kikangman/Surfshot/hardware/kicad-integrated/BOM.csv

Ref | Value | Footprint | DNP | Sheet
J1 | PROTECTED_CELL |  | False | /b182998e-1854-4d79-868d-e37b2476ee9a
F1 | 6.3A provisional |  | False | /b182998e-1854-4d79-868d-e37b2476ee9a
U2 | TPS62162DSG | Package_SON:Texas_DSG0008A_WSON-8-1EP_2x2mm_P0.5mm_EP0.9x1.6mm_ThermalVias | False | /b182998e-1854-4d79-868d-e37b2476ee9a
C1 | 10u / 10V | Capacitor_SMD:C_0805_2012Metric | False | /b182998e-1854-4d79-868d-e37b2476ee9a
L1 | 2.2uH / Isat>=2A |  | False | /b182998e-1854-4d79-868d-e37b2476ee9a
C2 | 22u / 10V | Capacitor_SMD:C_0805_2012Metric | False | /b182998e-1854-4d79-868d-e37b2476ee9a
U1 | ESP32-WROOM-32E-N4 | RF_Module:ESP32-WROOM-32E | False | /b182998e-1854-4d79-868d-e37b2476ee9a
C3 | 10u / 10V | Capacitor_SMD:C_0805_2012Metric | False | /b182998e-1854-4d79-868d-e37b2476ee9a
C4 | 100n | Capacitor_SMD:C_0603_1608Metric | False | /b182998e-1854-4d79-868d-e37b2476ee9a
U3 | ULN2003A | Package_SO:SOIC-16_3.9x9.9mm_P1.27mm | False | /b182998e-1854-4d79-868d-e37b2476ee9a
J4 | MOTOR_A |  | False | /b182998e-1854-4d79-868d-e37b2476ee9a
C5 | 100n / 25V | Capacitor_SMD:C_0603_1608Metric | False | /b182998e-1854-4d79-868d-e37b2476ee9a
R1 | 47k | Resistor_SMD:R_0603_1608Metric | False | /b182998e-1854-4d79-868d-e37b2476ee9a
R2 | 47k | Resistor_SMD:R_0603_1608Metric | False | /b182998e-1854-4d79-868d-e37b2476ee9a
R3 | 47k | Resistor_SMD:R_0603_1608Metric | False | /b182998e-1854-4d79-868d-e37b2476ee9a
R4 | 47k | Resistor_SMD:R_0603_1608Metric | False | /b182998e-1854-4d79-868d-e37b2476ee9a
U4 | ULN2003A | Package_SO:SOIC-16_3.9x9.9mm_P1.27mm | False | /b182998e-1854-4d79-868d-e37b2476ee9a
J5 | MOTOR_B |  | False | /b182998e-1854-4d79-868d-e37b2476ee9a
C6 | 100n / 25V | Capacitor_SMD:C_0603_1608Metric | False | /b182998e-1854-4d79-868d-e37b2476ee9a
R5 | 47k | Resistor_SMD:R_0603_1608Metric | False | /b182998e-1854-4d79-868d-e37b2476ee9a
R6 | 47k | Resistor_SMD:R_0603_1608Metric | False | /b182998e-1854-4d79-868d-e37b2476ee9a
R7 | 47k | Resistor_SMD:R_0603_1608Metric | False | /b182998e-1854-4d79-868d-e37b2476ee9a
R8 | 47k | Resistor_SMD:R_0603_1608Metric | False | /b182998e-1854-4d79-868d-e37b2476ee9a
R9 | 10k | Resistor_SMD:R_0603_1608Metric | False | /b182998e-1854-4d79-868d-e37b2476ee9a
SW1 | RESET | Button_Switch_SMD:SW_SPST_TL3342 | False | /b182998e-1854-4d79-868d-e37b2476ee9a
R10 | 10k | Resistor_SMD:R_0603_1608Metric | False | /b182998e-1854-4d79-868d-e37b2476ee9a
SW2 | BOOT | Button_Switch_SMD:SW_SPST_TL3342 | False | /b182998e-1854-4d79-868d-e37b2476ee9a
C7 | 1u | Capacitor_SMD:C_0603_1608Metric | False | /b182998e-1854-4d79-868d-e37b2476ee9a
R11 | 10k | Resistor_SMD:R_0603_1608Metric | False | /b182998e-1854-4d79-868d-e37b2476ee9a
R12 | 10k | Resistor_SMD:R_0603_1608Metric | False | /b182998e-1854-4d79-868d-e37b2476ee9a
R13 | 100k 1% | Resistor_SMD:R_0603_1608Metric | False | /b182998e-1854-4d79-868d-e37b2476ee9a
R14 | 100k 1% | Resistor_SMD:R_0603_1608Metric | False | /b182998e-1854-4d79-868d-e37b2476ee9a
C8 | 100n | Capacitor_SMD:C_0603_1608Metric | False | /b182998e-1854-4d79-868d-e37b2476ee9a
J2 | UART_3V3_LEVEL |  | False | /b182998e-1854-4d79-868d-e37b2476ee9a
J3 | LORA_EXPANSION |  | False | /b182998e-1854-4d79-868d-e37b2476ee9a
U5 | TPS61089RNR | Package_DFN_QFN:Texas_VQFN-RNR0011A-11 | False | /b182998e-1854-4d79-868d-e37b2476ee9a/4dbb8aff-9271-4933-bceb-92a873d27105
L2 | 2.2uH / Isat>=8A |  | False | /b182998e-1854-4d79-868d-e37b2476ee9a/4dbb8aff-9271-4933-bceb-92a873d27105
C9 | 22u / 10V | Capacitor_SMD:C_1206_3216Metric | False | /b182998e-1854-4d79-868d-e37b2476ee9a/4dbb8aff-9271-4933-bceb-92a873d27105
C10 | 100n / 16V | Capacitor_SMD:C_0603_1608Metric | False | /b182998e-1854-4d79-868d-e37b2476ee9a/4dbb8aff-9271-4933-bceb-92a873d27105
C16 | 100n / 16V | Capacitor_SMD:C_0603_1608Metric | False | /b182998e-1854-4d79-868d-e37b2476ee9a/4dbb8aff-9271-4933-bceb-92a873d27105
R18 | 316k 1% | Resistor_SMD:R_0603_1608Metric | False | /b182998e-1854-4d79-868d-e37b2476ee9a/4dbb8aff-9271-4933-bceb-92a873d27105
R15 | 312k 0.1% | Resistor_SMD:R_0603_1608Metric | False | /b182998e-1854-4d79-868d-e37b2476ee9a/4dbb8aff-9271-4933-bceb-92a873d27105
R16 | 100k 0.1% | Resistor_SMD:R_0603_1608Metric | False | /b182998e-1854-4d79-868d-e37b2476ee9a/4dbb8aff-9271-4933-bceb-92a873d27105
C11 | 22u / 25V | Capacitor_SMD:C_1210_3225Metric | False | /b182998e-1854-4d79-868d-e37b2476ee9a/4dbb8aff-9271-4933-bceb-92a873d27105
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
C23 | 15n | Capacitor_SMD:C_0603_1608Metric | False | /b182998e-1854-4d79-868d-e37b2476ee9a/4dbb8aff-9271-4933-bceb-92a873d27105
C24 | 10p DNP | Capacitor_SMD:C_0603_1608Metric | True | /b182998e-1854-4d79-868d-e37b2476ee9a/4dbb8aff-9271-4933-bceb-92a873d27105
