kikangman/Surfshot/hardware/kicad-integrated/Power.kicad_sch

## KiCad design hardware/kicad-integrated/Power.kicad_sch (2026-10-28)

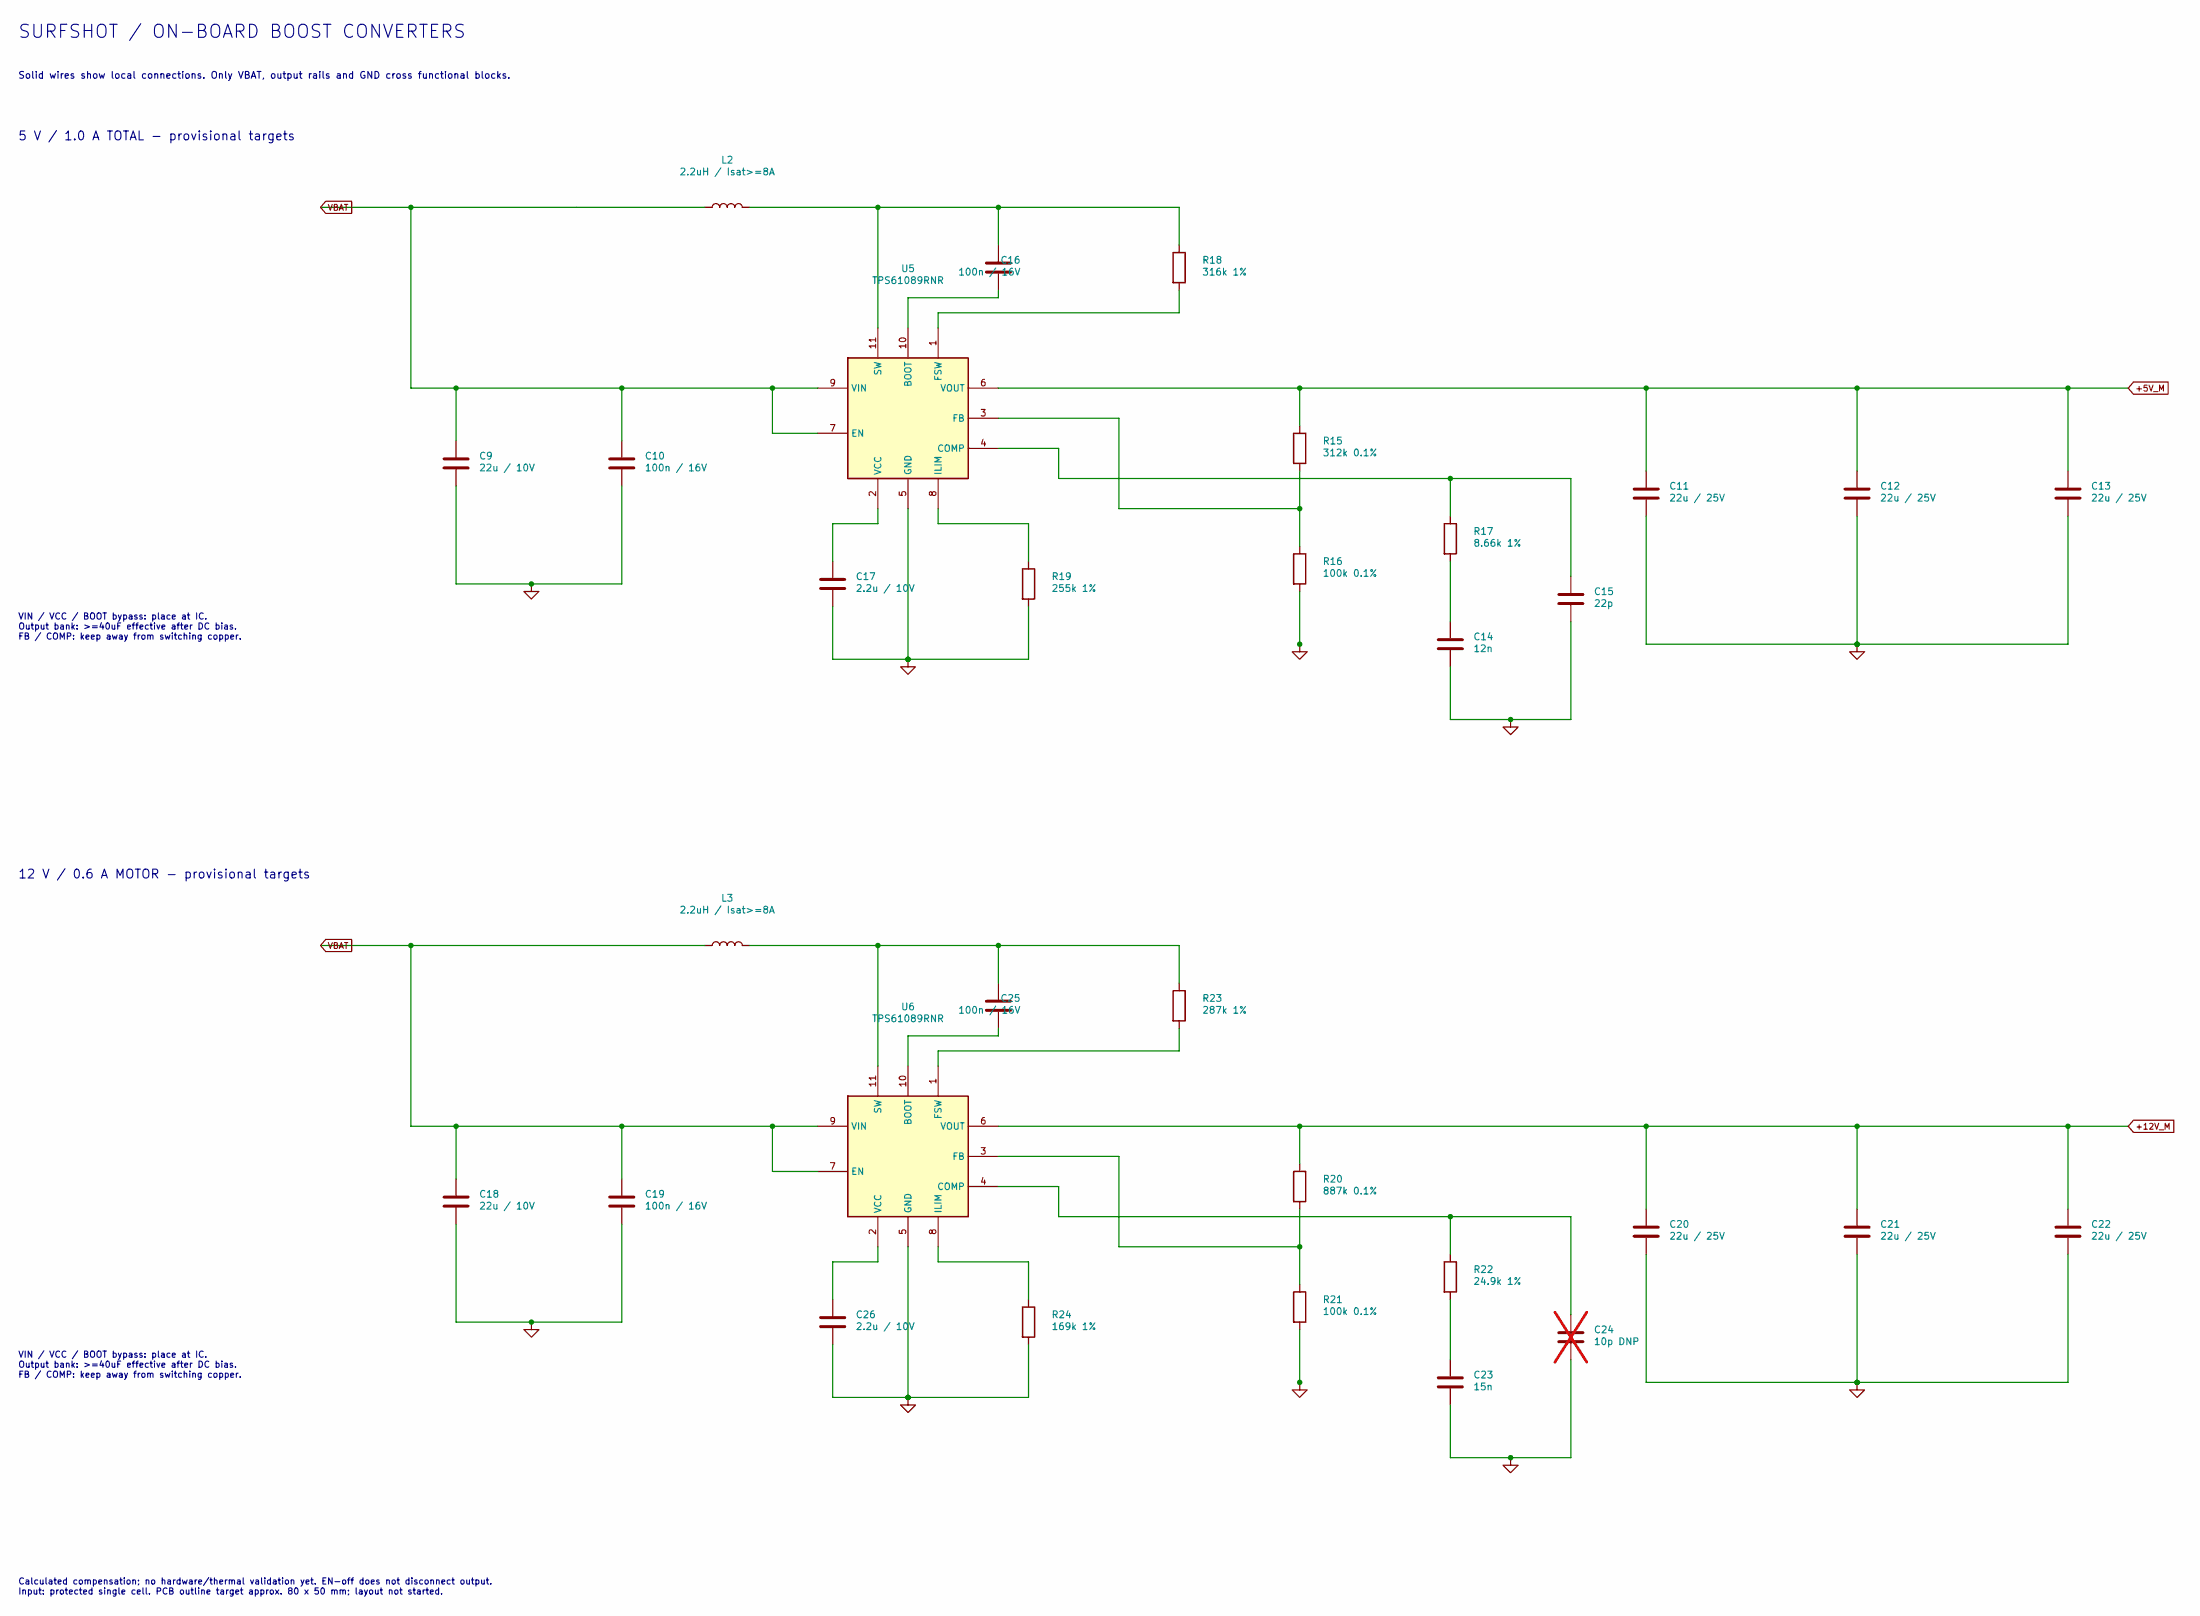
[picture p1: schematic Power.kicad_sch]

Parts:
C9, C18: 22u / 10V; C_1206_3216Metric
C10, C16, C19, C25: 100n / 16V; C_0603_1608Metric
C11, C12, C13, C20, C21, C22: 22u / 25V; C_1210_3225Metric
C14: 12n; C_0603_1608Metric
C15: 22p; C_0603_1608Metric
C17, C26: 2.2u / 10V; C_0603_1608Metric
C23: 15n; C_0603_1608Metric
C24: 10p DNP; C_0603_1608Metric; not fitted
L2, L3: 2.2uH / Isat>=8A
R15: 312k 0.1%; R_0603_1608Metric
R16, R21: 100k 0.1%; R_0603_1608Metric
R17: 8.66k 1%; R_0603_1608Metric
R18: 316k 1%; R_0603_1608Metric
R19: 255k 1%; R_0603_1608Metric
R20: 887k 0.1%; R_0603_1608Metric
R22: 24.9k 1%; R_0603_1608Metric
R23: 287k 1%; R_0603_1608Metric
R24: 169k 1%; R_0603_1608Metric
U5, U6: TPS61089RNR; Texas_VQFN-RNR0011A-11

Connections:
+5V_M: C11.1, C12.1, C13.1, R15.1, U5.6 (VOUT)
+12V_M: C20.1, C21.1, C22.1, R20.1, U6.6 (VOUT)
GND: C9.2, C10.2, C11.2, C12.2, C13.2, C14.2, C15.2, C17.2, C18.2, C19.2, C20.2, C21.2, C22.2, C23.2, C24.2, C26.2, R16.2, R19.2, R21.2, R24.2, U5.5 (GND), U6.5 (GND)
unnamed: C14.1, R17.2
unnamed: C15.1, R17.1, U5.4 (COMP)
unnamed: C16.1, U5.10 (BOOT)
unnamed: C16.2, L2.2, R18.1, U5.11 (SW)
unnamed: C17.1, U5.2 (VCC)
unnamed: C23.1, R22.2
unnamed: C24.1, R22.1, U6.4 (COMP)
unnamed: C25.1, U6.10 (BOOT)
unnamed: C25.2, L3.2, R23.1, U6.11 (SW)
unnamed: C26.1, U6.2 (VCC)
unnamed: R15.2, R16.1, U5.3 (FB)
unnamed: R18.2, U5.1 (FSW)
unnamed: R19.1, U5.8 (ILIM)
unnamed: R20.2, R21.1, U6.3 (FB)
unnamed: R23.2, U6.1 (FSW)
unnamed: R24.1, U6.8 (ILIM)
VBAT: C9.1, C10.1, C18.1, C19.1, L2.1, L3.1, U5.7 (EN), U5.9 (VIN), U6.7 (EN), U6.9 (VIN)

Notes on the sheet:
SURFSHOT / ON-BOARD BOOST CONVERTERS
Solid wires show local connections. Only VBAT, output rails and GND cross functional blocks.
5 V / 1.0 A TOTAL - provisional targets
VIN / VCC / BOOT bypass: place at IC. Output bank: >=40uF effective after DC bias. FB / COMP: keep away from switching copper.
12 V / 0.6 A MOTOR - provisional targets
Calculated compensation; no hardware/thermal validation yet. EN-off does not disconnect output. Input: protected single cell. PCB outline target approx. 80 x 50 mm; layout not started.
