kikangman/Surfshot/hardware/kicad-integrated/Surfshot_Integrated.kicad_sch

## KiCad design hardware/kicad-integrated/Surfshot_Integrated.kicad_sch (2026-10-28)

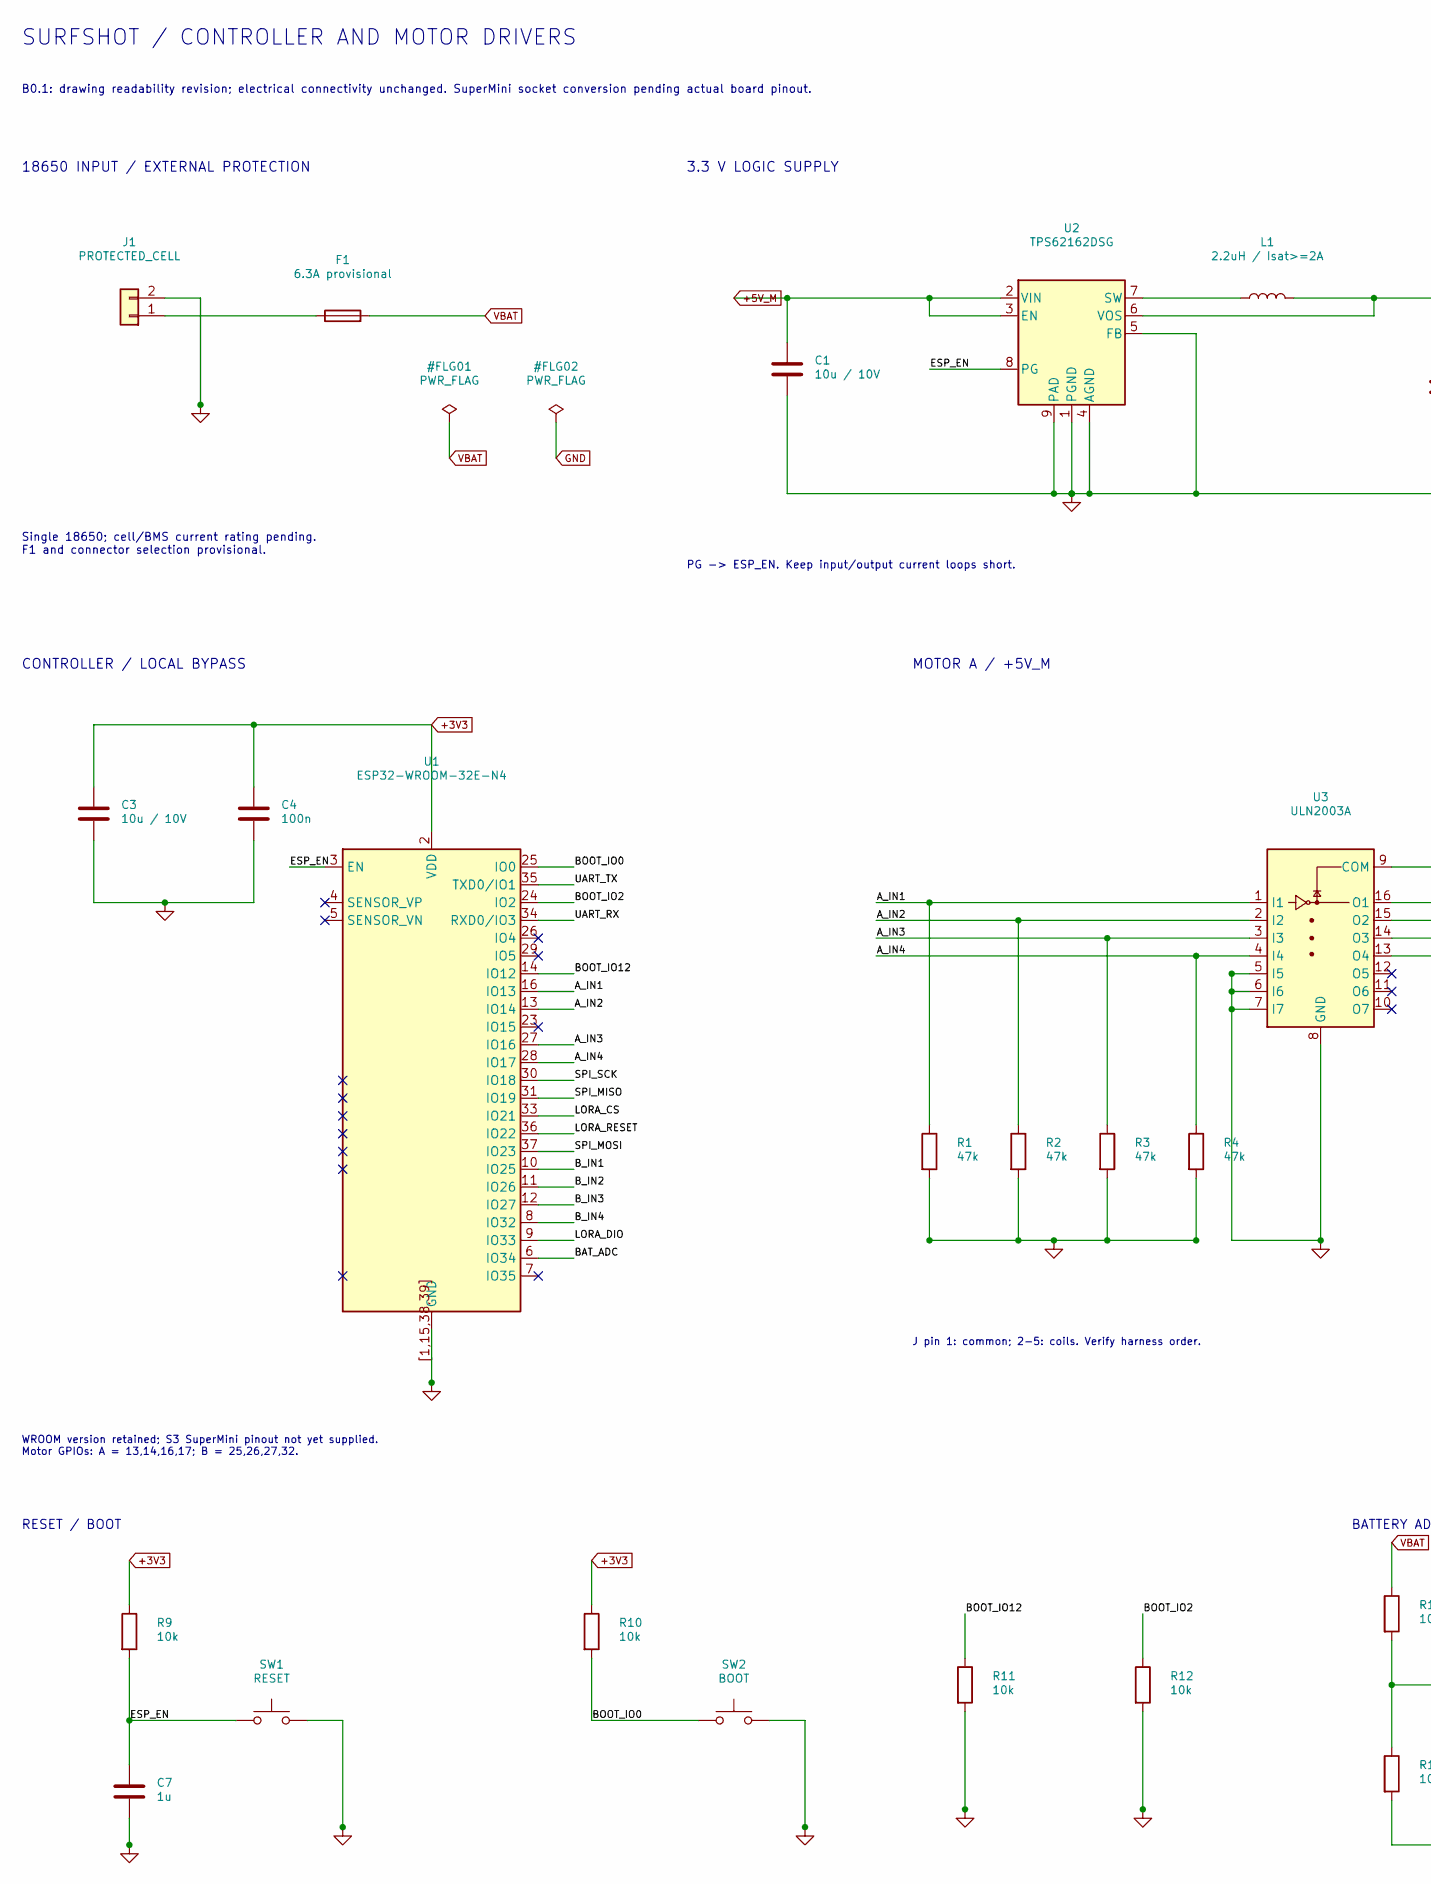
[picture p2: schematic Surfshot_Integrated.kicad_sch, part in row 1, column 1]

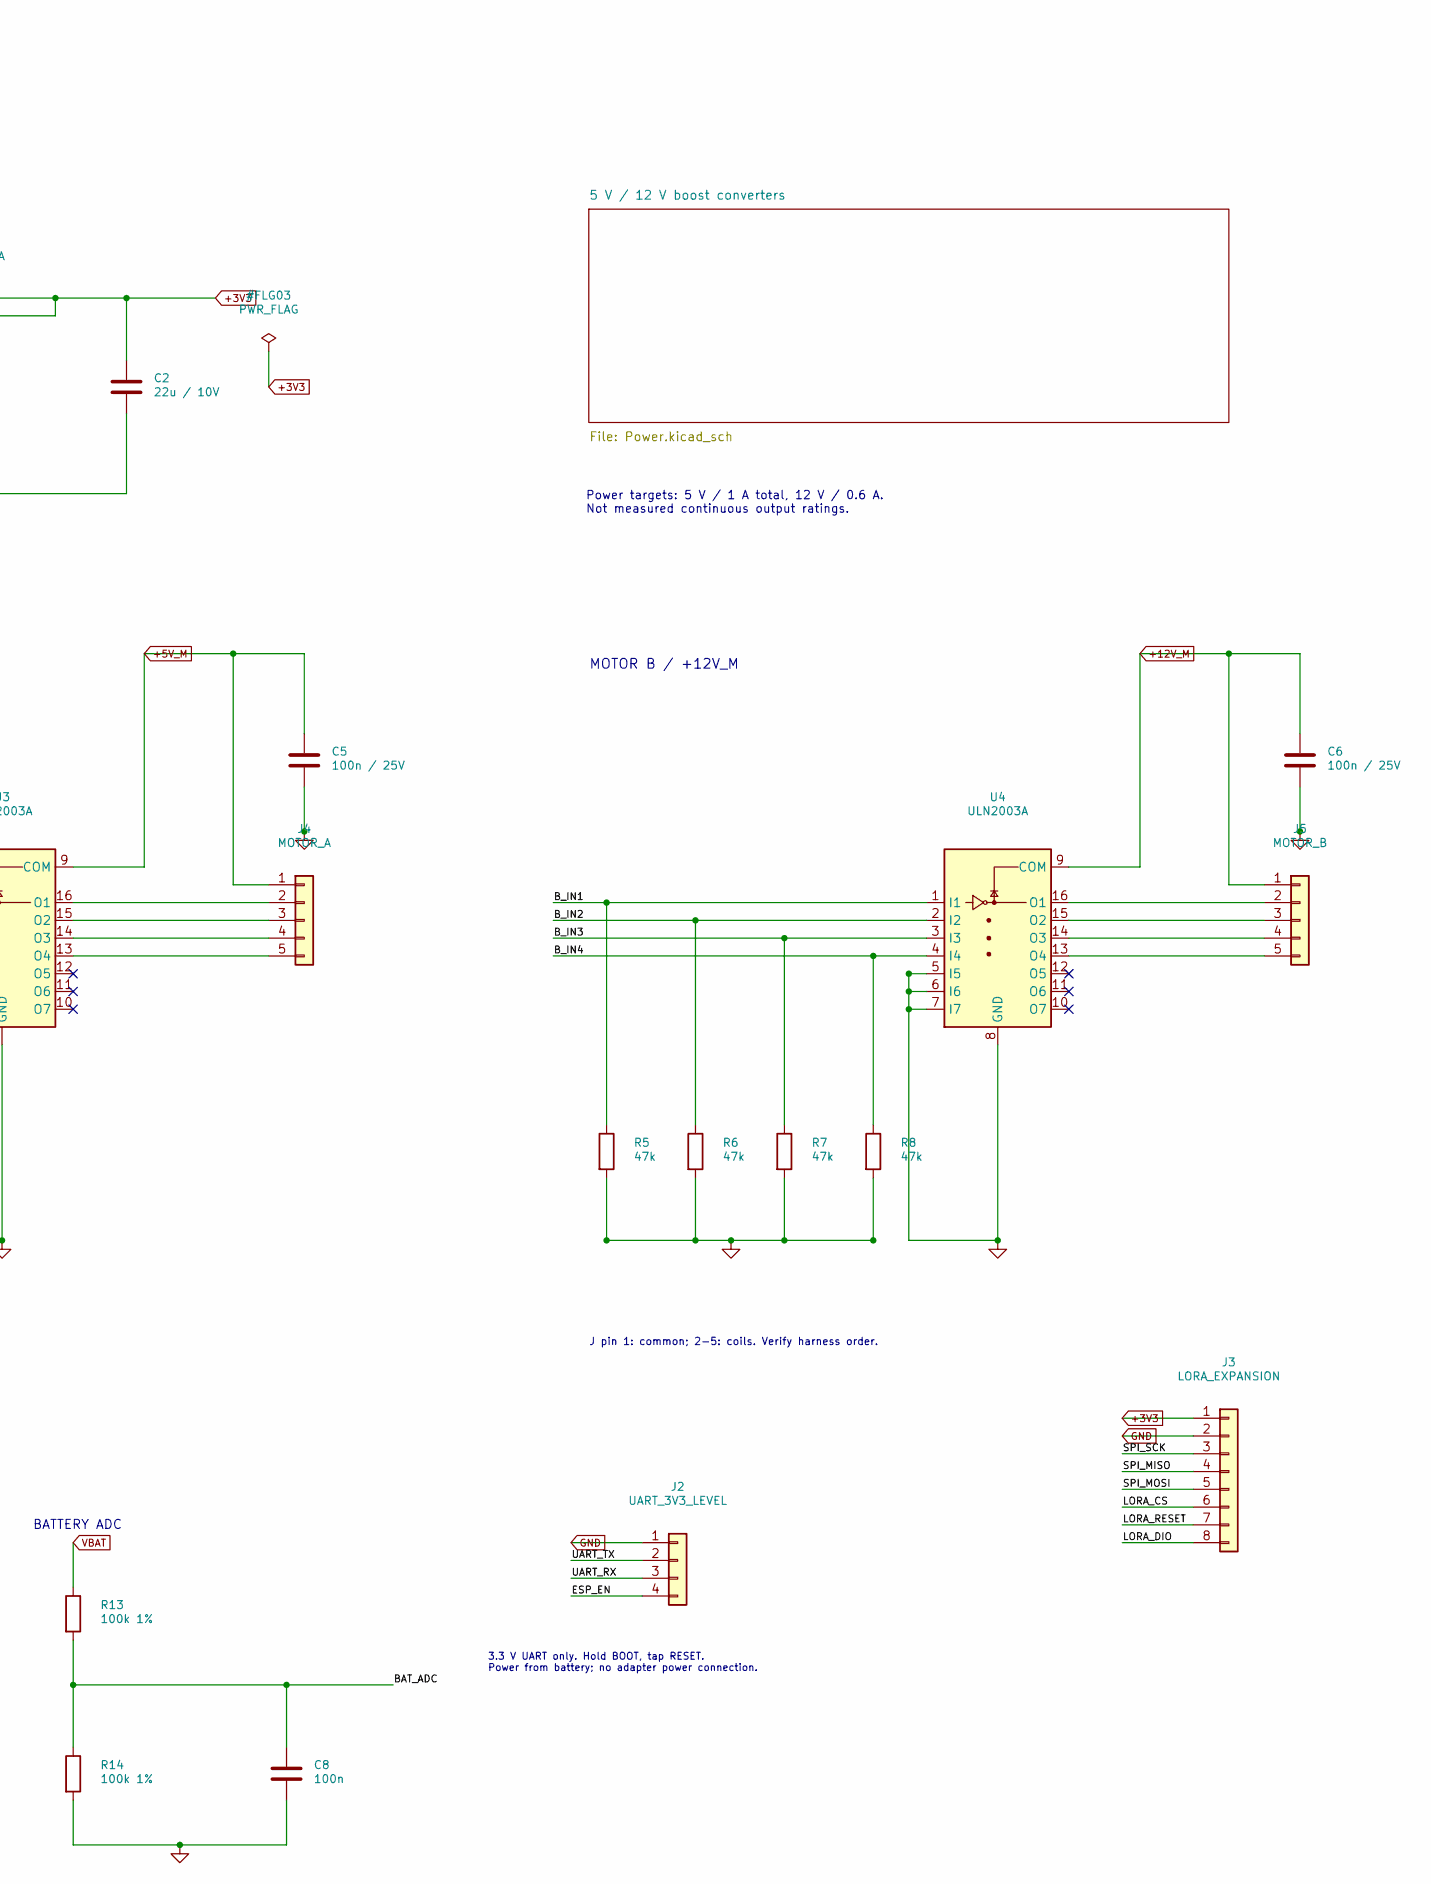
[picture p3: schematic Surfshot_Integrated.kicad_sch, part in row 1, column 2]

Parts:
C1, C3: 10u / 10V; C_0805_2012Metric
C2: 22u / 10V; C_0805_2012Metric
C4, C8: 100n; C_0603_1608Metric
C5, C6: 100n / 25V; C_0603_1608Metric
C7: 1u; C_0603_1608Metric
F1: 6.3A provisional
J1: PROTECTED_CELL
J2: UART_3V3_LEVEL
J3: LORA_EXPANSION
J4: MOTOR_A
J5: MOTOR_B
L1: 2.2uH / Isat>=2A
R1, R2, R3, R4, R5, R6, R7, R8: 47k; R_0603_1608Metric
R9, R10, R11, R12: 10k; R_0603_1608Metric
R13, R14: 100k 1%; R_0603_1608Metric
SW1: RESET; SW_SPST_TL3342
SW2: BOOT; SW_SPST_TL3342
U1: ESP32-WROOM-32E-N4; ESP32-WROOM-32E
U2: TPS62162DSG; Texas_DSG0008A_WSON-8-1EP_2x2mm_P0.5mm_EP0.9x1.6mm_ThermalV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
U3, U4: ULN2003A; SOIC-16_3.9x9.9mm_P1.27mm

Connections:
+3V3: C2.1, C3.1, C4.1, J3.1, L1.2, R9.1, R10.1, U1.2 (VDD), U2.6 (VOS)
+5V_M: C1.1, C5.1, J4.1, U2.2 (VIN), U2.3 (EN), U3.9 (COM)
+12V_M: C6.1, J5.1, U4.9 (COM)
A_IN1: R1.1, U1.16 (IO13), U3.1 (I1)
A_IN2: R2.1, U1.13 (IO14), U3.2 (I2)
A_IN3: R3.1, U1.27 (IO16), U3.3 (I3)
A_IN4: R4.1, U1.28 (IO17), U3.4 (I4)
BAT_ADC: C8.1, R13.2, R14.1, U1.6 (IO34)
BOOT_IO0: R10.2, SW2.1, U1.25 (IO0)
BOOT_IO2: R12.1, U1.24 (IO2)
BOOT_IO12: R11.1, U1.14 (IO12)
B_IN1: R5.1, U1.10 (IO25), U4.1 (I1)
B_IN2: R6.1, U1.11 (IO26), U4.2 (I2)
B_IN3: R7.1, U1.12 (IO27), U4.3 (I3)
B_IN4: R8.1, U1.8 (IO32), U4.4 (I4)
ESP_EN: C7.1, J2.4, R9.2, SW1.1, U1.3 (EN), U2.8 (PG)
GND: C1.2, C2.2, C3.2, C4.2, C5.2, C6.2, C7.2, C8.2, J1.2, J2.1, J3.2, R1.2, R2.2, R3.2, R4.2, R5.2, R6.2, R7.2, R8.2, R11.2, R12.2, R14.2, SW1.2, SW2.2, U1.[1,15,38,39] (GND), U2.1 (PGND), U2.4 (AGND), U2.5 (FB), U2.9 (PAD), U3.5 (I5), U3.6 (I6), U3.7 (I7), U3.8 (GND), U4.5 (I5), U4.6 (I6), U4.7 (I7), U4.8 (GND)
LORA_CS: J3.6, U1.33 (IO21)
LORA_DIO: J3.8, U1.9 (IO33)
LORA_RESET: J3.7, U1.36 (IO22)
unnamed: F1.1, J1.1
unnamed: J4.2, U3.16 (O1)
unnamed: J4.3, U3.15 (O2)
unnamed: J4.4, U3.14 (O3)
unnamed: J4.5, U3.13 (O4)
unnamed: J5.2, U4.16 (O1)
unnamed: J5.3, U4.15 (O2)
unnamed: J5.4, U4.14 (O3)
unnamed: J5.5, U4.13 (O4)
unnamed: L1.1, U2.7 (SW)
SPI_MISO: J3.4, U1.31 (IO19)
SPI_MOSI: J3.5, U1.37 (IO23)
SPI_SCK: J3.3, U1.30 (IO18)
UART_RX: J2.3, U1.34 (RXD0/IO3)
UART_TX: J2.2, U1.35 (TXD0/IO1)
VBAT: F1.2, R13.1

Notes on the sheet:
SURFSHOT / CONTROLLER AND MOTOR DRIVERS
B0.1: drawing readability revision; electrical connectivity unchanged. SuperMini socket conversion pending actual board pinout.
18650 INPUT / EXTERNAL PROTECTION
Single 18650; cell/BMS current rating pending. F1 and connector selection provisional.
3.3 V LOGIC SUPPLY
PG -> ESP_EN. Keep input/output current loops short.
Power targets: 5 V / 1 A total, 12 V / 0.6 A. Not measured continuous output ratings.
CONTROLLER / LOCAL BYPASS
WROOM version retained; S3 SuperMini pinout not yet supplied. Motor GPIOs: A = 13,14,16,17; B = 25,26,27,32.
MOTOR A / +5V_M
J pin 1: common; 2-5: coils. Verify harness order.
MOTOR B / +12V_M
RESET / BOOT
BATTERY ADC
3.3 V UART only. Hold BOOT, tap RESET. Power from battery; no adapter power connection.
