kikangman/Surfshot/hardware/kicad/Surfshot.kicad_sch

## KiCad design hardware/kicad/Surfshot.kicad_sch (2026-10-28)

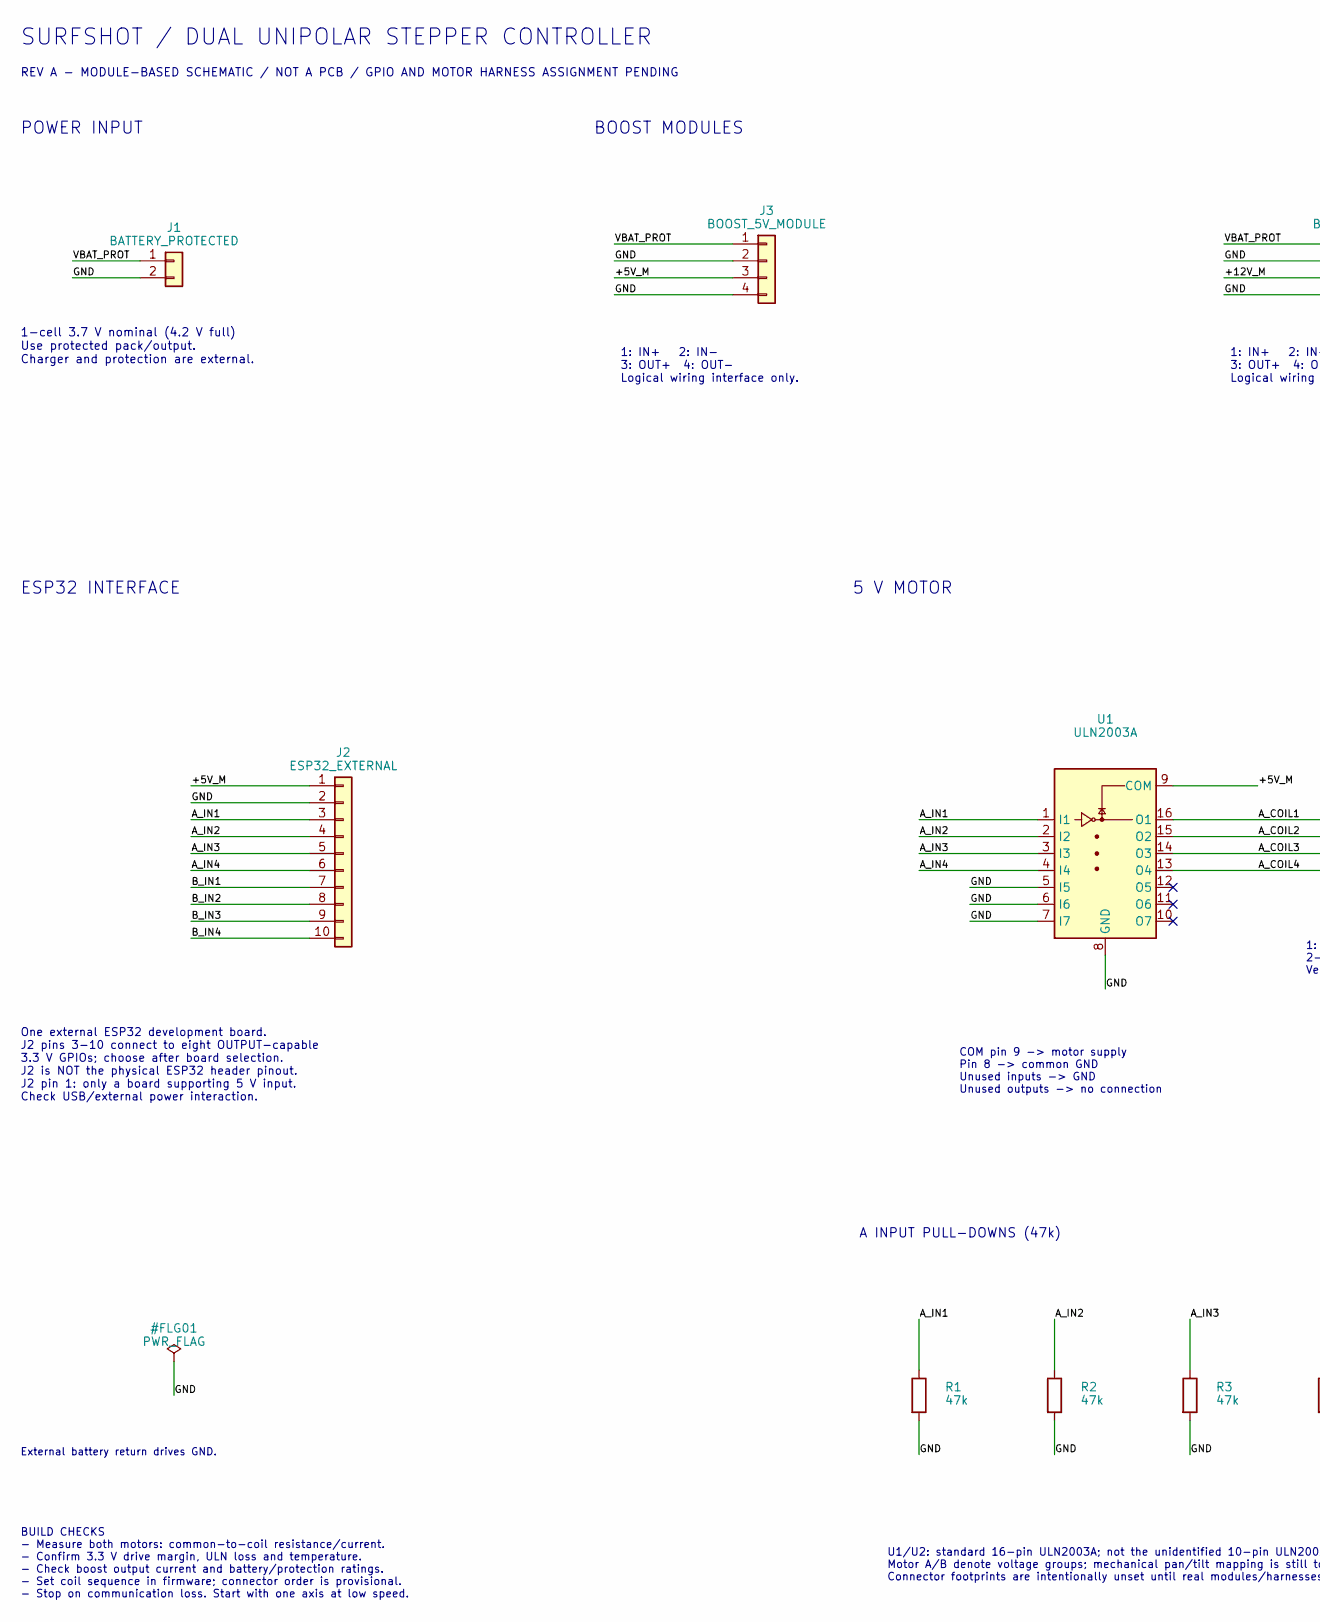
[picture p4: schematic Surfshot.kicad_sch, part in row 1, column 1]

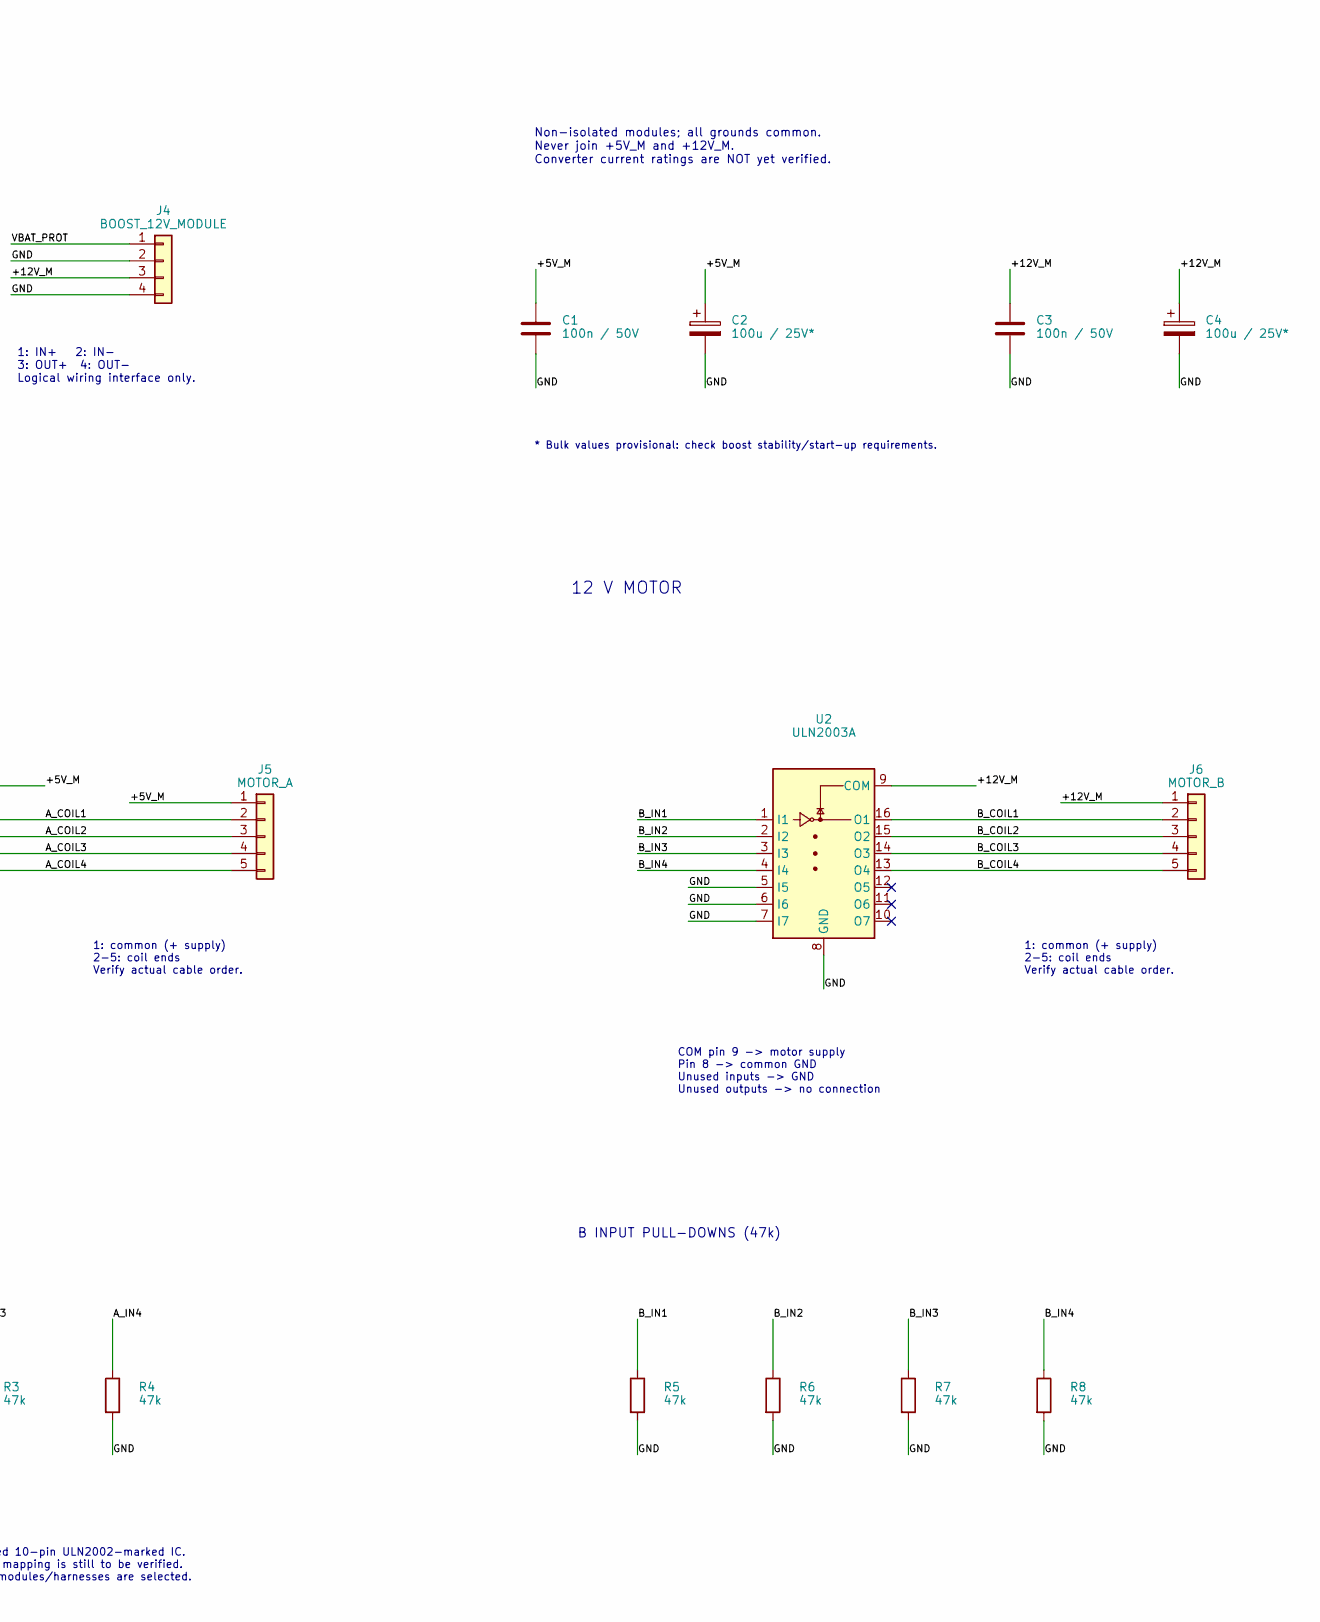
[picture p5: schematic Surfshot.kicad_sch, part in row 1, column 2]

Parts:
C1, C3: 100n / 50V
C2, C4: 100u / 25V*
J1: BATTERY_PROTECTED
J2: ESP32_EXTERNAL
J3: BOOST_5V_MODULE
J4: BOOST_12V_MODULE
J5: MOTOR_A
J6: MOTOR_B
R1, R2, R3, R4, R5, R6, R7, R8: 47k; R_Axial_DIN0207_L6.3mm_D2.5mm_P10.16mm_Horizontal
U1, U2: ULN2003A; DIP-16_W7.62mm

Connections:
+5V_M: C1.1, C2.1, J2.1, J3.3, J5.1, U1.9 (COM)
+12V_M: C3.1, C4.1, J4.3, J6.1, U2.9 (COM)
A_COIL1: J5.2, U1.16 (O1)
A_COIL2: J5.3, U1.15 (O2)
A_COIL3: J5.4, U1.14 (O3)
A_COIL4: J5.5, U1.13 (O4)
A_IN1: J2.3, R1.1, U1.1 (I1)
A_IN2: J2.4, R2.1, U1.2 (I2)
A_IN3: J2.5, R3.1, U1.3 (I3)
A_IN4: J2.6, R4.1, U1.4 (I4)
B_COIL1: J6.2, U2.16 (O1)
B_COIL2: J6.3, U2.15 (O2)
B_COIL3: J6.4, U2.14 (O3)
B_COIL4: J6.5, U2.13 (O4)
B_IN1: J2.7, R5.1, U2.1 (I1)
B_IN2: J2.8, R6.1, U2.2 (I2)
B_IN3: J2.9, R7.1, U2.3 (I3)
B_IN4: J2.10, R8.1, U2.4 (I4)
GND: C1.2, C2.2, C3.2, C4.2, J1.2, J2.2, J3.2, J3.4, J4.2, J4.4, R1.2, R2.2, R3.2, R4.2, R5.2, R6.2, R7.2, R8.2, U1.5 (I5), U1.6 (I6), U1.7 (I7), U1.8 (GND), U2.5 (I5), U2.6 (I6), U2.7 (I7), U2.8 (GND)
VBAT_PROT: J1.1, J3.1, J4.1

Notes on the sheet:
SURFSHOT / DUAL UNIPOLAR STEPPER CONTROLLER
REV A - MODULE-BASED SCHEMATIC / NOT A PCB / GPIO AND MOTOR HARNESS ASSIGNMENT PENDING
POWER INPUT
1-cell 3.7 V nominal (4.2 V full) Use protected pack/output. Charger and protection are external.
1: IN+ 2: IN- 3: OUT+ 4: OUT- Logical wiring interface only.
BOOST MODULES
Non-isolated modules; all grounds common. Never join +5V_M and +12V_M. Converter current ratings are NOT yet verified.
* Bulk values provisional: check boost stability/start-up requirements.
ESP32 INTERFACE
One external ESP32 development board. J2 pins 3-10 connect to eight OUTPUT-capable 3.3 V GPIOs; choose after board selection. J2 is NOT the physical ESP32 header pinout. J2 pin 1: only a board supporting 5 V input. Check USB/external power interaction.
5 V MOTOR
COM pin 9 -> motor supply Pin 8 -> common GND Unused inputs -> GND Unused outputs -> no connection
1: common (+ supply) 2-5: coil ends Verify actual cable order.
A INPUT PULL-DOWNS (47k)
12 V MOTOR
B INPUT PULL-DOWNS (47k)
External battery return drives GND.
BUILD CHECKS - Measure both motors: common-to-coil resistance/current. - Confirm 3.3 V drive margin, ULN loss and temperature. - Check boost output current and battery/protection ratings. - Set coil sequence in firmware; connector order is provisional. - Stop on communication loss. Start with one a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
U1/U2: standard 16-pin ULN2003A; not the unidentified 10-pin ULN2002-marked IC. Motor A/B denote voltage groups; mechanical pan/tilt mapping is still to be verified. Connector footprints are intentionally unset until real modules/harnesses are selected.
