kikangman/Surfshot/(commit log)

2026-10-28 docs: add Surfshot dual-motor wiring schematic
2026-10-28 hardware: add Surfshot.kicad_sch for dual-motor controller
    [Surfshot.kicad_sch]
2026-10-28 hardware: add Surfshot.kicad_pro for dual-motor controller
2026-10-28 hardware: add README.md for dual-motor controller
2026-10-28 docs: link editable KiCad schematic
2026-10-28 Add integrated controller Rev B0: BOM.csv
    [BOM.csv]
2026-10-28 Add integrated controller Rev B0: Surfshot_Integrated.kicad_sch
    [Surfshot_Integrated.kicad_sch]
2026-10-28 Add integrated controller Rev B0: Surfshot_Integrated.kicad_pro
2026-10-28 Add integrated controller Rev B0: Power.kicad_sch
    [Power.kicad_sch]
2026-10-28 Link integrated KiCad Rev B0 and clarify prototype status
2026-10-28 Redraw B0.1 with directly wired local circuit blocks: Surfshot_Integrated.kicad_sch
    [Surfshot_Integrated.kicad_sch]
2026-10-28 Redraw B0.1 with directly wired local circuit blocks: Power.kicad_sch
    [Power.kicad_sch]
2026-10-28 Redraw B0.1 with directly wired local circuit blocks: Surfshot.kicad_sym
2026-10-28 Redraw B0.1 with directly wired local circuit blocks: sym-lib-table
2026-10-28 Redraw B0.1 with directly wired local circuit blocks: BOM.csv
    [BOM.csv]
2026-10-28 Redraw B0.1 with directly wired local circuit blocks: README.md
